osu-asdt/beavs-6/3dmodels/REL0014B.stp

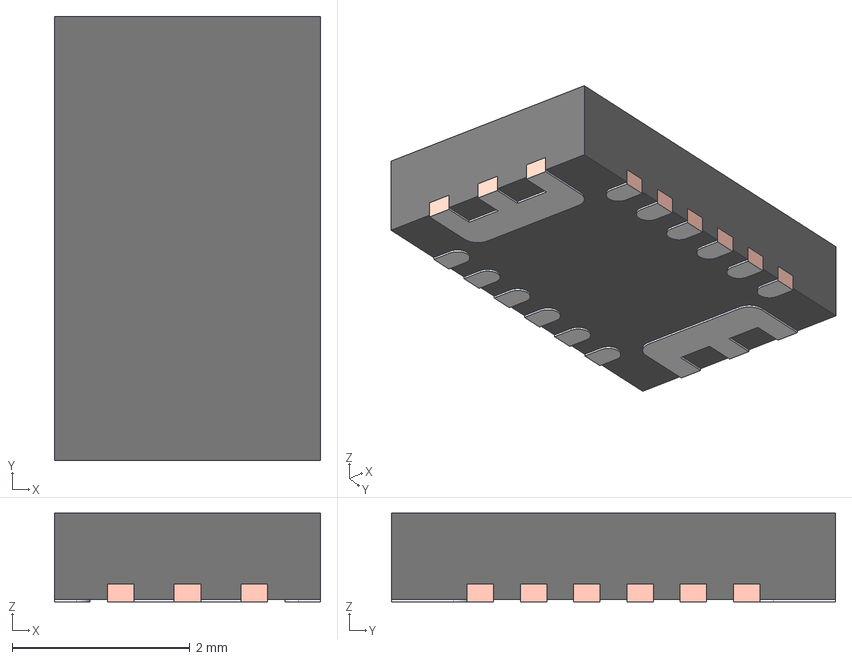
[picture p1: CAD file, 2025-11-22]
3dmodels/REL0014B.stp
3.00 x 5.00 x 1.00 mm
FRAME
PIN1_AREA
