osu-asdt/beavs-6/3dmodels/B3P-VH.STEP

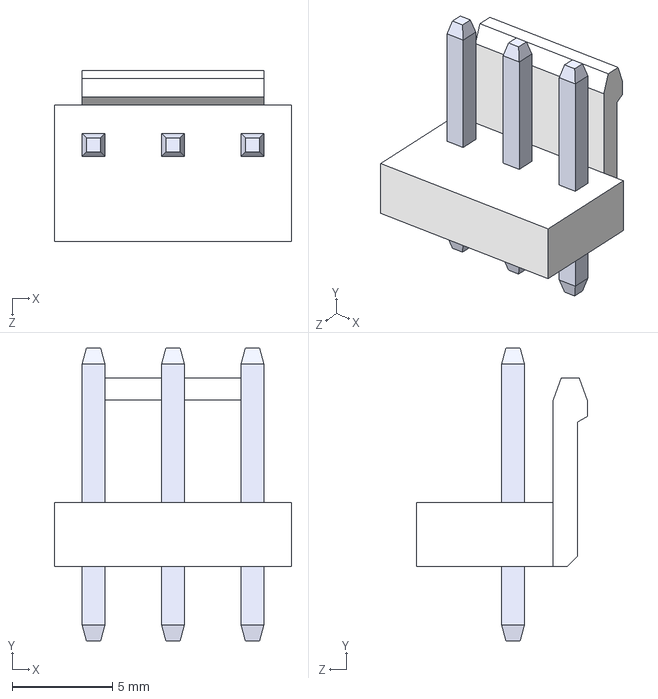
[picture p2: CAD file, 2025-11-22]
3dmodels/B3P-VH.STEP
11.8 x 14.6 x 8.50 mm
BxP-VH_3
pin x 3
