osu-asdt/beavs-6/beavs-sketch-0.kicad_pcb

## KiCad design beavs-sketch-0.kicad_pcb (2026-01-10)

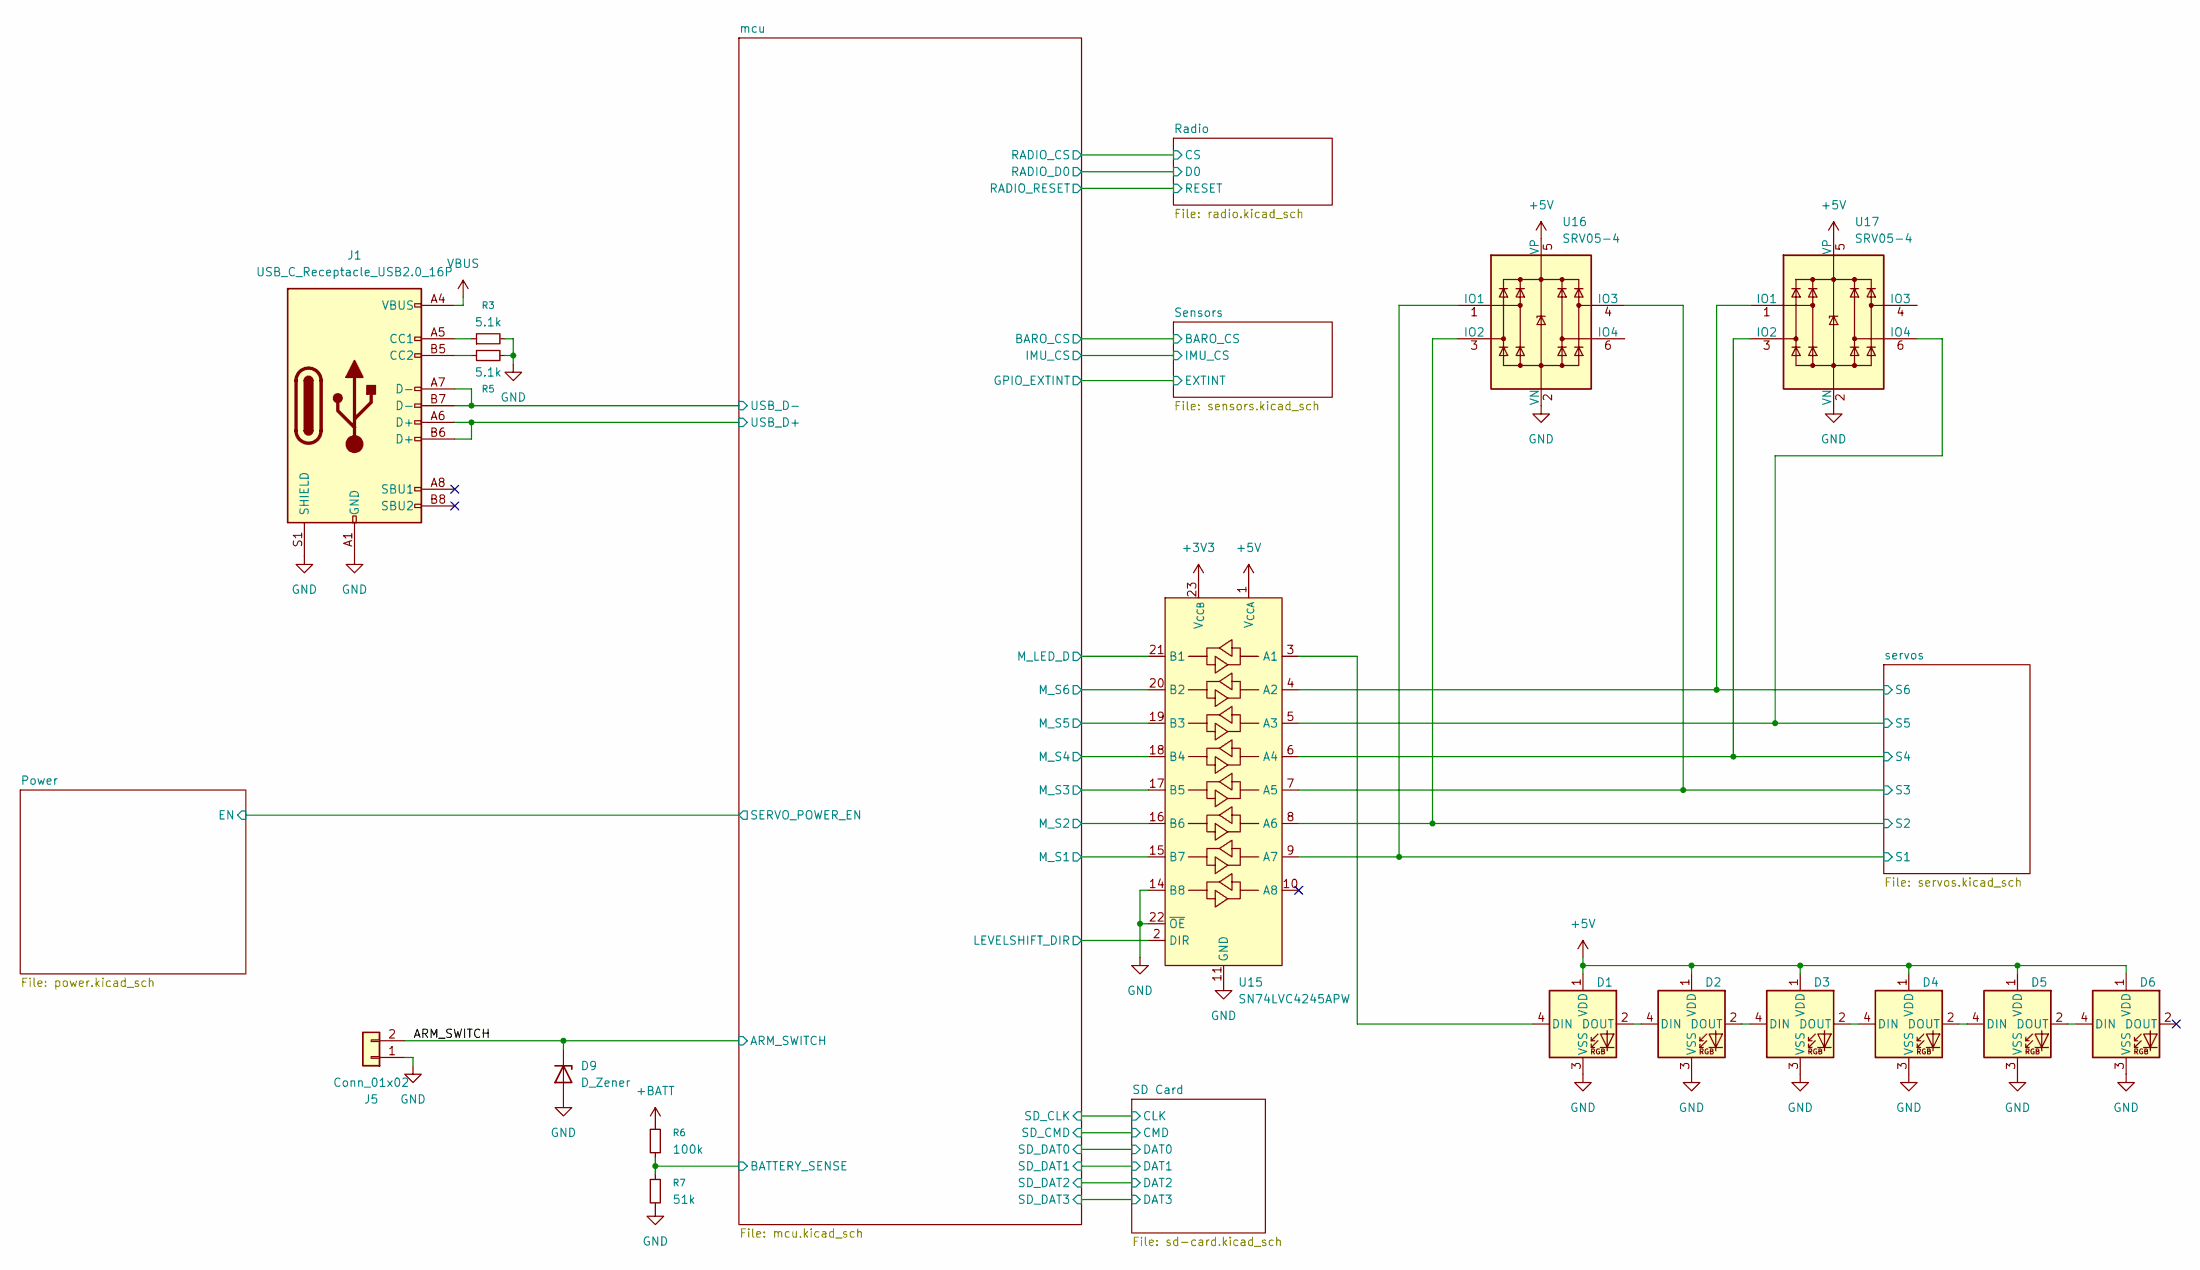
[picture p10: schematic beavs-sketch-0.kicad_sch]

Parts:
D1, D2, D3, D4, D5, D6: SK6812-EC20; LED_SK6812-EC20_PLCC4_2.0x2.0mm; LCSC C2909058
D9: D_Zener; D_SOD-323; LCSC C20615801
J1: USB_C_Receptacle_USB2.0_16P; USB_C_Receptacle_G-Switch_GT-USB-7010ASV; LCSC C2988369
J5: Conn_01x02; JST_PH_B2B-PH-K_1x02_P2.00mm_Vertical; digikey 455-1704-ND
R3, R5: 5.1k; R_0402_1005Metric; LCSC C25905
R6: 100k; R_0402_1005Metric; LCSC C25741
R7: 51k; R_0402_1005Metric; LCSC C25794
U15: SN74LVC4245APW; TSSOP-24_4.4x7.8mm_P0.65mm; LCSC C7859
U16, U17: SRV05-4; SOT-23-6; LCSC C7420376

Connections:
+3V3: U15.23 (V_{CCB}), U15.24 (V_{CCB}); also elsewhere on the board
+5V: D1.1 (VDD), D2.1 (VDD), D3.1 (VDD), D4.1 (VDD), D5.1 (VDD), D6.1 (VDD), U15.1 (V_{CCA}), U16.5 (VP), U17.5 (VP); also elsewhere on the board
+BATT: R6.1; also elsewhere on the board
/ARM_SWITCH: D9.1 (K), J5.2; also elsewhere on the board
/mcu/BATTERY_SENSE: R6.2, R7.1; also elsewhere on the board
/mcu/LEVELSHIFT_DIR: U15.2 (DIR); also elsewhere on the board
/mcu/M_LED_D: U15.21 (B1); also elsewhere on the board
/mcu/M_S1: U15.15 (B7); also elsewhere on the board
/mcu/M_S2: U15.16 (B6); also elsewhere on the board
/mcu/M_S3: U15.17 (B5); also elsewhere on the board
/mcu/M_S4: U15.18 (B4); also elsewhere on the board
/mcu/M_S5: U15.19 (B3); also elsewhere on the board
/mcu/M_S6: U15.20 (B2); also elsewhere on the board
/mcu/USB_D+: J1.A6 (D+), J1.B6 (D+); also elsewhere on the board
/mcu/USB_D-: J1.A7 (D-), J1.B7 (D-); also elsewhere on the board
/servos/S1: U15.9 (A7), U16.1 (IO1); also elsewhere on the board
/servos/S2: U15.8 (A6), U16.3 (IO2); also elsewhere on the board
/servos/S3: U15.7 (A5), U16.4 (IO3); also elsewhere on the board
/servos/S4: U15.6 (A4), U17.3 (IO2); also elsewhere on the board
/servos/S5: U15.5 (A3), U17.6 (IO4); also elsewhere on the board
/servos/S6: U15.4 (A2), U17.1 (IO1); also elsewhere on the board
GND: D1.3 (VSS), D2.3 (VSS), D3.3 (VSS), D4.3 (VSS), D5.3 (VSS), D6.3 (VSS), D9.2 (A), J1.A1 (GND), J1.A12 (GND), J1.B1 (GND), J1.B12 (GND), J1.S1 (SHIELD), J5.1, R3.2, R5.2, R7.2, U15.11 (GND), U15.12 (GND), U15.13 (GND), U15.14 (B8), U15.22 (~OE), U16.2 (VN), U17.2 (VN); also elsewhere on the board
unnamed: D1.4 (DIN), U15.3 (A1)
unnamed: D1.2 (DOUT), D2.4 (DIN)
unnamed: D2.2 (DOUT), D3.4 (DIN)
unnamed: D3.2 (DOUT), D4.4 (DIN)
unnamed: D4.2 (DOUT), D5.4 (DIN)
unnamed: D5.2 (DOUT), D6.4 (DIN)
unnamed: J1.A5 (CC1), R3.1
unnamed: J1.B5 (CC2), R5.1
VBUS: J1.A4 (VBUS), J1.A9 (VBUS), J1.B4 (VBUS), J1.B9 (VBUS); also elsewhere on the board

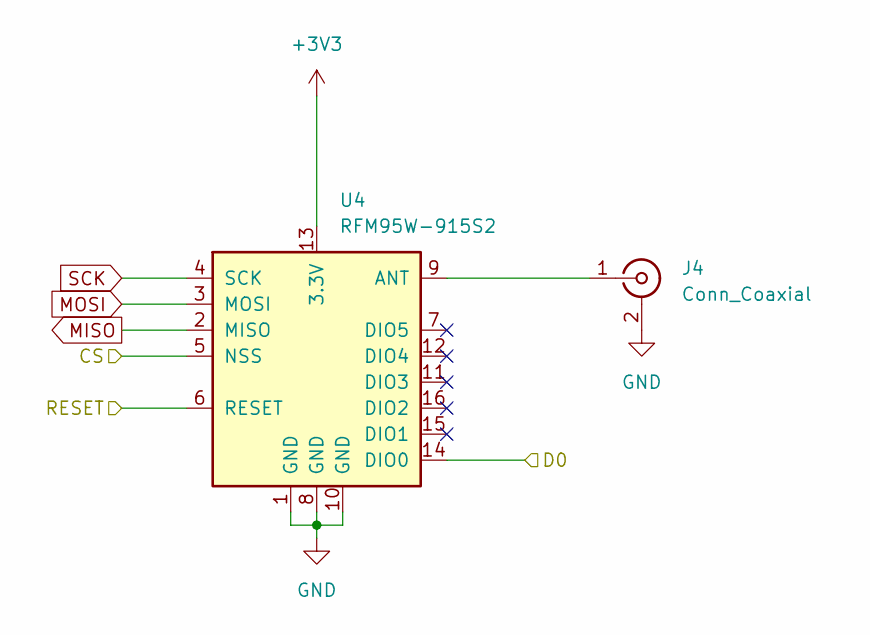
[picture p11: schematic radio.kicad_sch]

Parts:
J4: Conn_Coaxial; U.FL_Hirose_U.FL-R-SMT-1_Vertical; LCSC C88374
U4: RFM95W-915S2; HOPERF_RFM9XW_SMD

Connections:
+3V3: U4.13 (3.3V); also elsewhere on the board
/Radio/CS: U4.5 (NSS); also elsewhere on the board
/Radio/D0: U4.14 (DIO0); also elsewhere on the board
/Radio/RESET: U4.6 (RESET); also elsewhere on the board
GND: J4.2 (Ext), U4.1 (GND), U4.8 (GND), U4.10 (GND); also elsewhere on the board
MISO: U4.2 (MISO); also elsewhere on the board
MOSI: U4.3 (MOSI); also elsewhere on the board
unnamed: J4.1 (In), U4.9 (ANT)
SCK: U4.4 (SCK); also elsewhere on the board

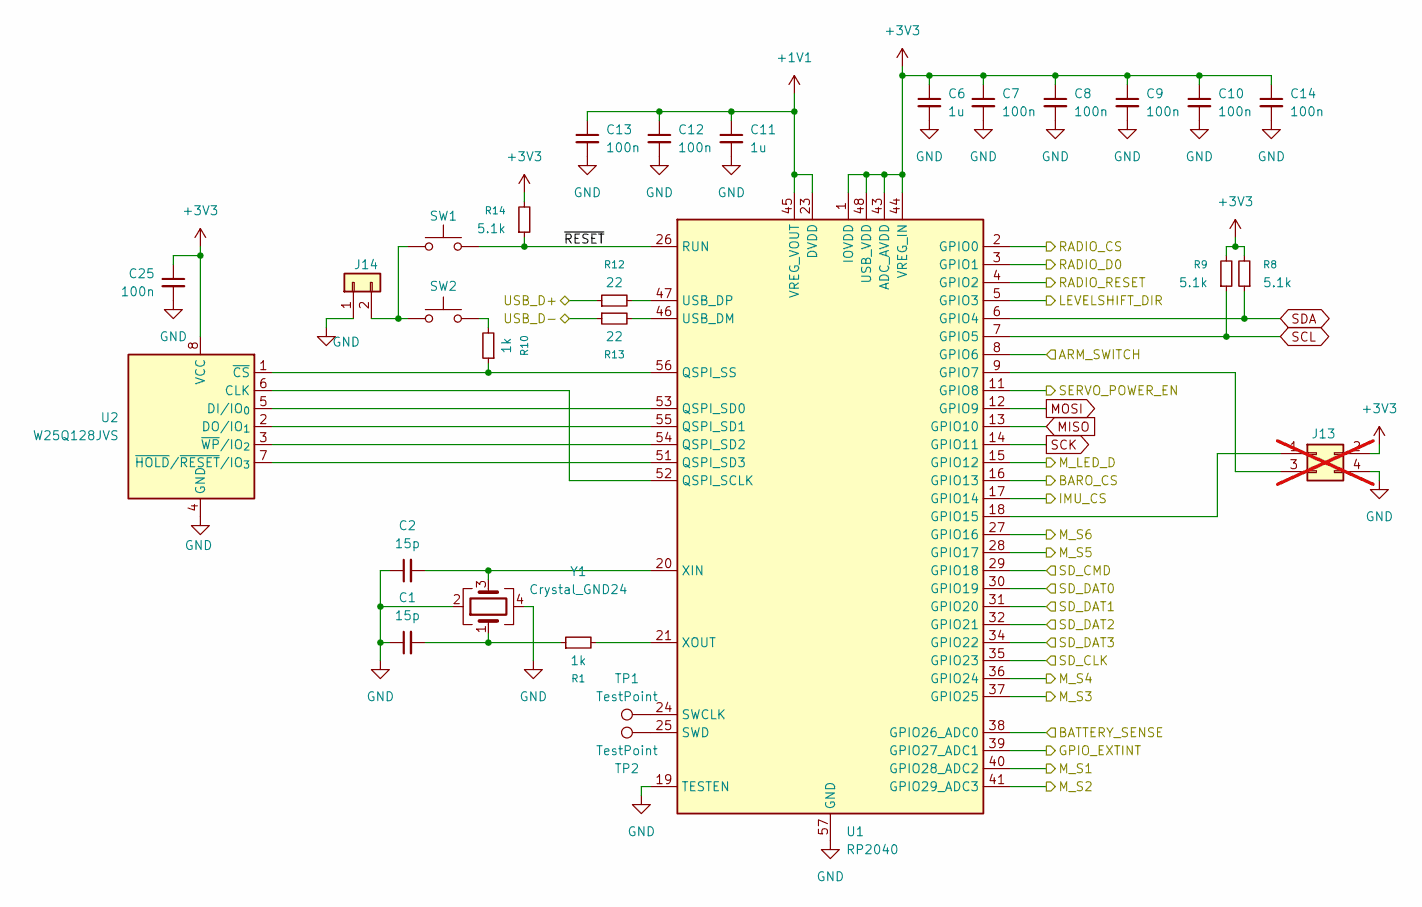
[picture p12: schematic mcu.kicad_sch]

Parts:
C1, C2: 15p; C_0402_1005Metric; LCSC C1548
C6, C11: 1u; C_0402_1005Metric; LCSC C52923
C7, C8, C9, C10, C12, C13, C14, C25: 100n; C_0402_1005Metric; LCSC C1525
J13: Conn_02x02_Odd_Even; PinHeader_2x02_P1.27mm_Vertical; not fitted
J14: Conn_01x02; PinHeader_1x02_P1.27mm_Vertical; digikey SAM1156-01-ND
R1, R10: 1k; R_0402_1005Metric; LCSC C11702
R8, R9, R14: 5.1k; R_0402_1005Metric; LCSC C25905
R12, R13: 22; R_0402_1005Metric; LCSC C25079
SW1, SW2: SW_Push; SW_SPST_TS-1088-AR02016; LCSC C720477
TP1, TP2: TestPoint; TestPoint_Pad_D1.0mm
U1: RP2040; QFN-56-1EP_7x7mm_P0.4mm_EP3.2x3.2mm; LCSC C2040
U2: W25Q128JVS; SOIC-8_5.3x5.3mm_P1.27mm; LCSC C97521
Y1: Crystal_GND24; Crystal_SMD_Abracon_ABM8AIG-4Pin_3.2x2.5mm; LCSC C20625731

Connections:
+1V1: C11.1, C12.1, C13.1, U1.23 (DVDD), U1.45 (VREG_VOUT), U1.50 (DVDD)
+3V3: C6.1, C7.1, C8.1, C9.1, C10.1, C14.1, C25.1, J13.2, R8.2, R9.2, R14.2, U1.1 (IOVDD), U1.10 (IOVDD), U1.22 (IOVDD), U1.33 (IOVDD), U1.42 (IOVDD), U1.43 (ADC_AVDD), U1.44 (VREG_IN), U1.48 (USB_VDD), U1.49 (IOVDD), U2.8 (VCC); also elsewhere on the board
/ARM_SWITCH: U1.8 (GPIO6); also elsewhere on the board
/Power/EN: U1.11 (GPIO8); also elsewhere on the board
/Radio/CS: U1.2 (GPIO0); also elsewhere on the board
/Radio/D0: U1.3 (GPIO1); also elsewhere on the board
/Radio/RESET: U1.4 (GPIO2); also elsewhere on the board
/SD Card/CLK: U1.35 (GPIO23); also elsewhere on the board
/SD Card/CMD: U1.29 (GPIO18); also elsewhere on the board
/SD Card/DAT0: U1.30 (GPIO19); also elsewhere on the board
/SD Card/DAT1: U1.31 (GPIO20); also elsewhere on the board
/SD Card/DAT2: U1.32 (GPIO21); also elsewhere on the board
/SD Card/DAT3: U1.34 (GPIO22); also elsewhere on the board
/Sensors/BARO_CS: U1.16 (GPIO13); also elsewhere on the board
/Sensors/EXTINT: U1.39 (GPIO27_ADC1); also elsewhere on the board
/Sensors/IMU_CS: U1.17 (GPIO14); also elsewhere on the board
/mcu/BATTERY_SENSE: U1.38 (GPIO26_ADC0); also elsewhere on the board
/mcu/LEVELSHIFT_DIR: U1.5 (GPIO3); also elsewhere on the board
/mcu/M_LED_D: U1.15 (GPIO12); also elsewhere on the board
/mcu/M_S1: U1.40 (GPIO28_ADC2); also elsewhere on the board
/mcu/M_S2: U1.41 (GPIO29_ADC3); also elsewhere on the board
/mcu/M_S3: U1.37 (GPIO25); also elsewhere on the board
/mcu/M_S4: U1.36 (GPIO24); also elsewhere on the board
/mcu/M_S5: U1.28 (GPIO17); also elsewhere on the board
/mcu/M_S6: U1.27 (GPIO16); also elsewhere on the board
/mcu/USB_D+: R12.1; also elsewhere on the board
/mcu/USB_D-: R13.1; also elsewhere on the board
/mcu/~RESET: R14.1, SW1.2, U1.26 (RUN)
GND: C1.1, C2.1, C6.2, C7.2, C8.2, C9.2, C10.2, C11.2, C12.2, C13.2, C14.2, C25.2, J13.4, J14.1, U1.19 (TESTEN), U1.57 (GND), U2.4 (GND), Y1.2, Y1.4; also elsewhere on the board
MISO: U1.13 (GPIO10); also elsewhere on the board
MOSI: U1.12 (GPIO9); also elsewhere on the board
unnamed: C1.2, R1.1, Y1.1
unnamed: J13.1, U1.18 (GPIO15)
unnamed: J13.3, U1.9 (GPIO7)
unnamed: J14.2, SW1.1, SW2.1
unnamed: R10.2, SW2.2
unnamed: U1.52 (QSPI_SCLK), U2.6 (CLK)
unnamed: U1.53 (QSPI_SD0), U2.5 (DI/IO_{0})
unnamed: U1.55 (QSPI_SD1), U2.2 (DO/IO_{1})
unnamed: U1.54 (QSPI_SD2), U2.3 (~WP/IO_{2})
unnamed: U1.51 (QSPI_SD3), U2.7 (~HOLD/~RESET/IO_{3})
unnamed: R10.1, U1.56 (QSPI_SS), U2.1 (~CS)
unnamed: TP1.1, U1.24 (SWCLK)
unnamed: TP2.1, U1.25 (SWD)
unnamed: R13.2, U1.46 (USB_DM)
unnamed: R12.2, U1.47 (USB_DP)
unnamed: C2.2, U1.20 (XIN), Y1.3
unnamed: R1.2, U1.21 (XOUT)
SCK: U1.14 (GPIO11); also elsewhere on the board
SCL: R9.1, U1.7 (GPIO5); also elsewhere on the board
SDA: R8.1, U1.6 (GPIO4); also elsewhere on the board

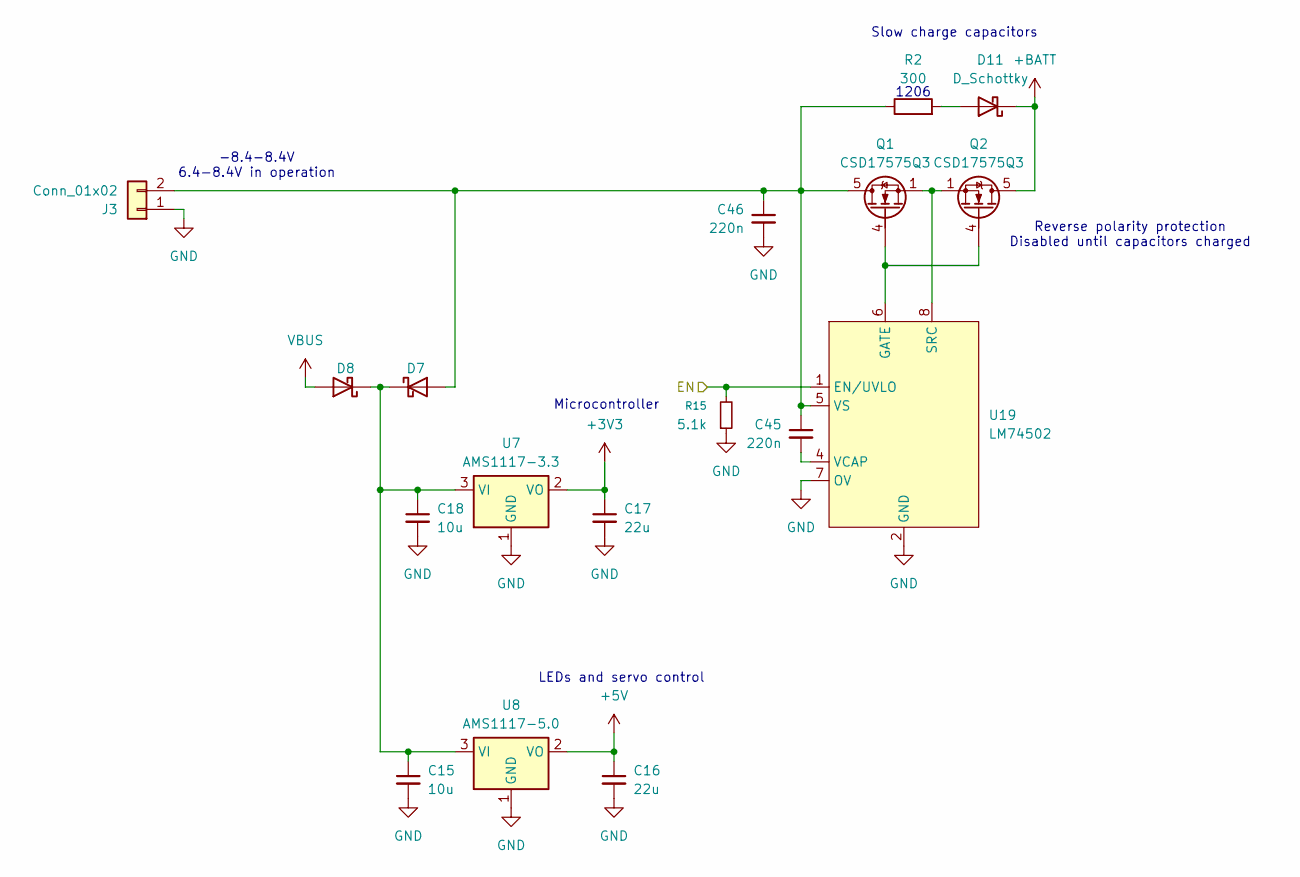
[picture p13: schematic power.kicad_sch]

Parts:
C15, C18: 10u; C_0603_1608Metric; LCSC C19702
C16, C17: 22u; C_0603_1608Metric; LCSC C59461
C45, C46: 220n; C_0402_1005Metric; LCSC C16772
D7, D8, D11: D_Schottky; D_SOD-123; LCSC C8598
J3: Conn_01x02; AMASS_XT30UPB-M_1x02_P5.0mm_Vertical
Q1, Q2: CSD17575Q3; SON-8-1EP-3.3x3.3mm-nexfet; LCSC C529277
R2: 300; R_1206_3216Metric; LCSC C17887
R15: 5.1k; R_0402_1005Metric; LCSC C25905
U7: AMS1117-3.3; SOT-223-3_TabPin2; LCSC C6186
U8: AMS1117-5.0; SOT-223-3_TabPin2; LCSC C6187
U19: LM74502; SOT-23-8-THIN; LCSC C5219203

Connections:
+3V3: C17.1, U7.2 (VO); also elsewhere on the board
+5V: C16.1, U8.2 (VO); also elsewhere on the board
+BATT: D11.1 (K), Q2.5 (D); also elsewhere on the board
/Power/EN: R15.2, U19.1 (EN/UVLO); also elsewhere on the board
GND: C15.2, C16.2, C17.2, C18.2, C46.2, J3.1, R15.1, U7.1 (GND), U8.1 (GND), U19.2 (GND), U19.7 (OV); also elsewhere on the board
unnamed: C45.1, C46.1, D7.2 (A), J3.2, Q1.5 (D), R2.1, U19.5 (VS)
unnamed: C15.1, C18.1, D7.1 (K), D8.1 (K), U7.3 (VI), U8.3 (VI)
unnamed: D11.2 (A), R2.2
unnamed: Q1.4 (G), Q2.4 (G), U19.6 (GATE)
unnamed: Q1.1 (S), Q1.2 (S), Q1.3 (S), Q2.1 (S), Q2.2 (S), Q2.3 (S), U19.8 (SRC)
unnamed: C45.2, U19.4 (VCAP)
VBUS: D8.2 (A); also elsewhere on the board

Notes on the sheet:
Slow charge capacitors
1206
Microcontroller
-8.4-8.4V 6.4-8.4V in operation
Reverse polarity protection Disabled until capacitors charged
LEDs and servo control

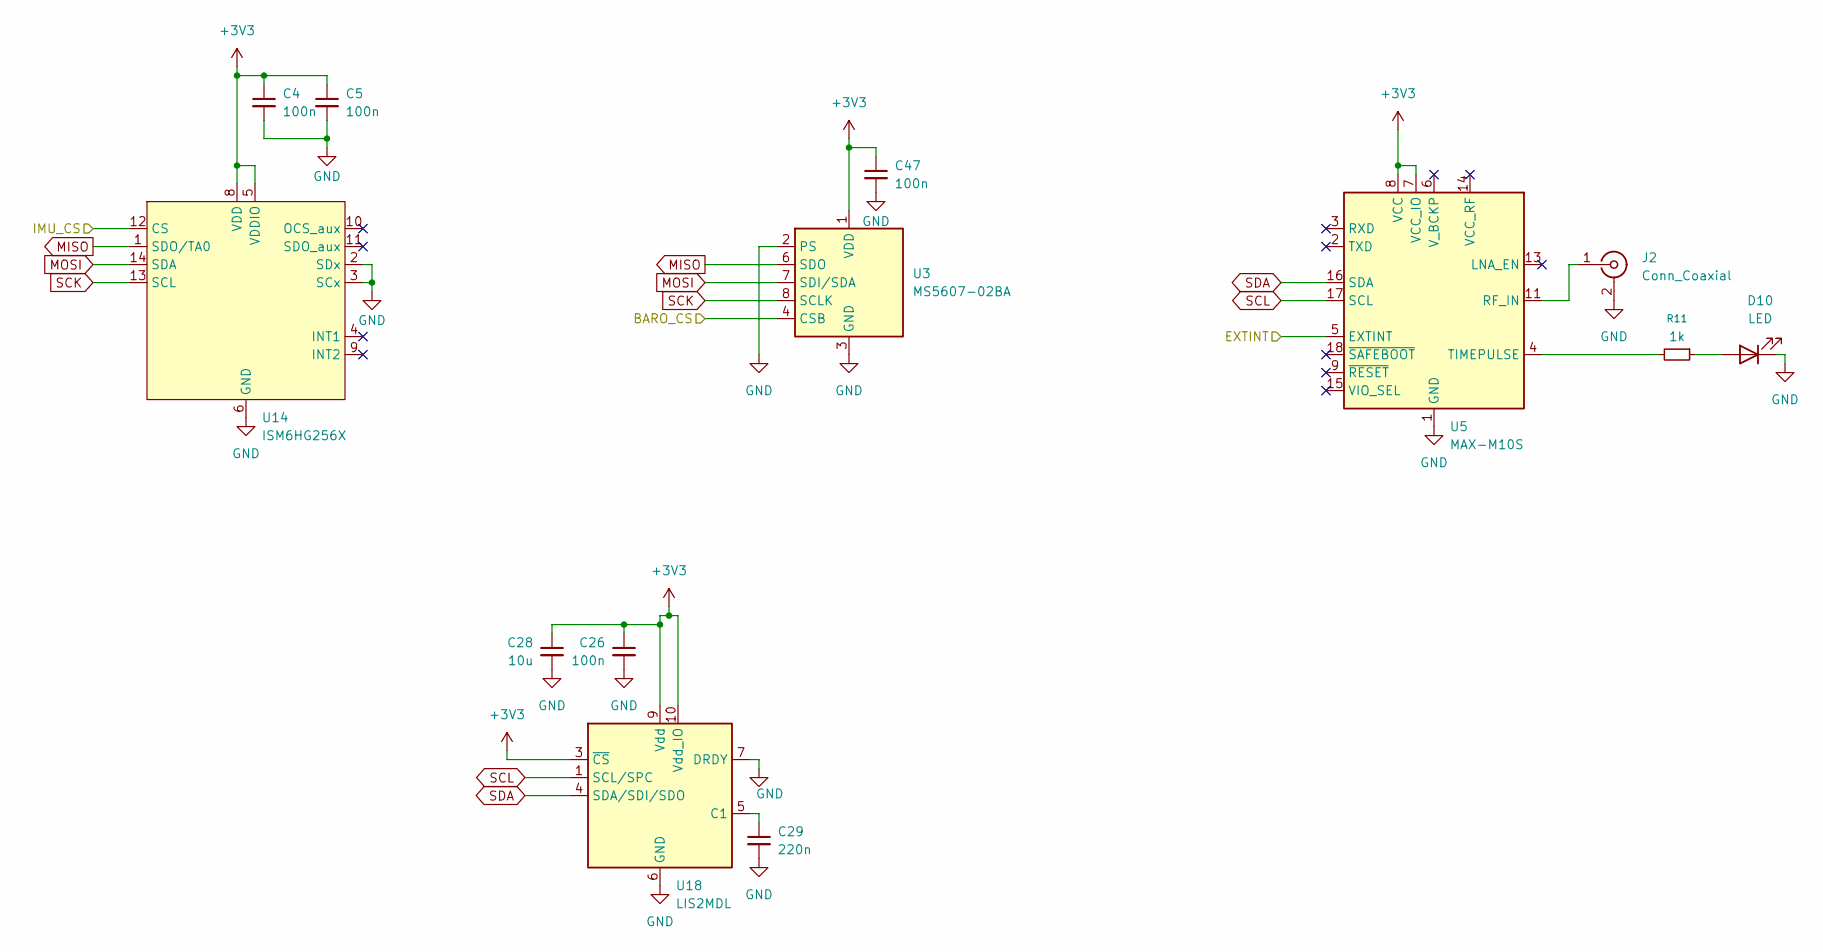
[picture p14: schematic sensors.kicad_sch]

Parts:
C4, C5, C26, C47: 100n; C_0402_1005Metric; LCSC C1525
C28: 10u; C_0402_1005Metric; LCSC C15525
C29: 220n; C_0402_1005Metric; LCSC C16772
D10: LED; LED_0805_2012Metric; LCSC C2297
J2: Conn_Coaxial; U.FL_Hirose_U.FL-R-SMT-1_Vertical; LCSC C88374
R11: 1k; R_0402_1005Metric; LCSC C11702
U3: MS5607-02BA; LGA-8_3x5mm_P1.25mm; LCSC C97627
U5: MAX-M10S; ublox_MAX; digikey 672-MAX-M10S-00BCT-ND
U14: ISM6HG256X; LGA-14_3x2.5mm_P0.5mm_LayoutBorder3x4y; digikey 497-ISM6HG256XTRCT-ND
U18: LIS2MDL; LGA-12_2x2mm_P0.5mm; digikey 497-17588-1-ND

Connections:
+3V3: C4.1, C5.1, C26.1, C28.1, C47.1, U3.1 (VDD), U5.7 (VCC_IO), U5.8 (VCC), U14.5 (VDDIO), U14.8 (VDD), U18.3 (~CS), U18.9 (Vdd), U18.10 (Vdd_IO); also elsewhere on the board
/Sensors/BARO_CS: U3.4 (CSB), U3.5 (CSB); also elsewhere on the board
/Sensors/EXTINT: U5.5 (EXTINT); also elsewhere on the board
/Sensors/IMU_CS: U14.12 (CS); also elsewhere on the board
GND: C4.2, C5.2, C26.2, C28.2, C29.2, C47.2, D10.1 (K), J2.2 (Ext), U3.2 (PS), U3.3 (GND), U5.1 (GND), U5.10 (GND), U5.12 (GND), U14.2 (SDx), U14.3 (SCx), U14.6 (GND), U14.7 (GND), U18.6 (GND), U18.7 (DRDY), U18.8 (GND); also elsewhere on the board
MISO: U3.6 (SDO), U14.1 (SDO/TA0); also elsewhere on the board
MOSI: U3.7 (SDI/SDA), U14.14 (SDA); also elsewhere on the board
unnamed: D10.2 (A), R11.1
unnamed: J2.1 (In), U5.11 (RF_IN)
unnamed: R11.2, U5.4 (TIMEPULSE)
unnamed: C29.1, U18.5 (C1)
SCK: U3.8 (SCLK), U14.13 (SCL); also elsewhere on the board
SCL: U5.17 (SCL), U18.1 (SCL/SPC); also elsewhere on the board
SDA: U5.16 (SDA), U18.4 (SDA/SDI/SDO); also elsewhere on the board

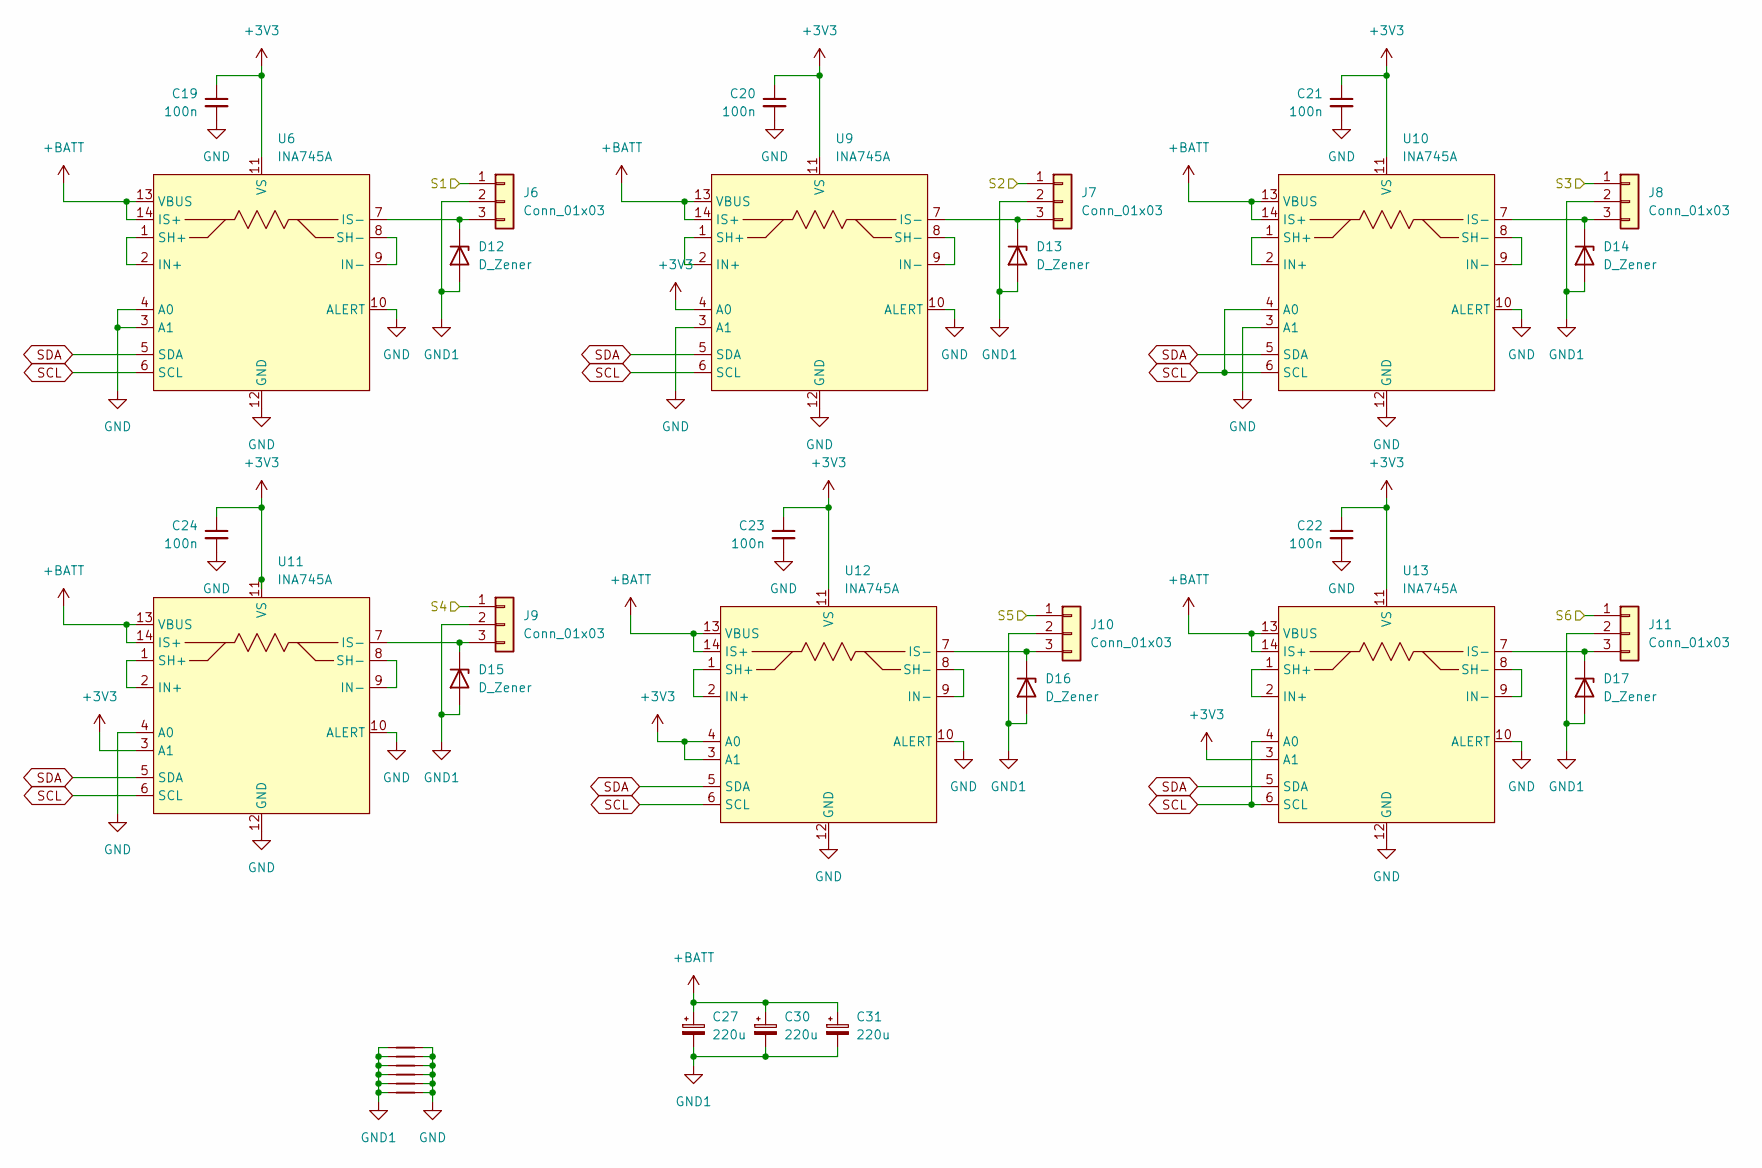
[picture p15: schematic servos.kicad_sch]

Parts:
C19, C20, C21, C22, C23, C24: 100n; C_0402_1005Metric; LCSC C1525
C27, C30, C31: 220u; CP_Radial_D5.0mm_P2.00mm; digikey 399-ESK227M010AC3AA-ND
D12, D13, D14, D15, D16, D17: D_Zener; Nexperia_CFP3_SOD-123W; digikey 1727-5361-1-ND
J6, J7, J8, J9, J10, J11: Conn_01x03; JST_VH_B3P-VH-B_1x03_P3.96mm_Vertical_model; digikey 455-B3P-VH-ND
NT1, NT2, NT3, NT4, NT5, NT6: NetTie_2; NetTie-2_SMD_Pad2.0mm
U6, U9, U10, U11, U12, U13: INA745A; QFN-14-REL_TI; LCSC C35213810

Connections:
+3V3: C19.1, C20.1, C21.1, C22.1, C23.1, C24.1, U6.11 (VS), U9.4 (A0), U9.11 (VS), U10.11 (VS), U11.3 (A1), U11.11 (VS), U12.3 (A1), U12.4 (A0), U12.11 (VS), U13.3 (A1), U13.11 (VS); also elsewhere on the board
+BATT: C27.1, C30.1, C31.1, U6.13 (VBUS), U6.14 (IS+), U9.13 (VBUS), U9.14 (IS+), U10.13 (VBUS), U10.14 (IS+), U11.13 (VBUS), U11.14 (IS+), U12.13 (VBUS), U12.14 (IS+), U13.13 (VBUS), U13.14 (IS+); also elsewhere on the board
/servos/S1: J6.1; also elsewhere on the board
/servos/S2: J7.1; also elsewhere on the board
/servos/S3: J8.1; also elsewhere on the board
/servos/S4: J9.1; also elsewhere on the board
/servos/S5: J10.1; also elsewhere on the board
/servos/S6: J11.1; also elsewhere on the board
GND: C19.2, C20.2, C21.2, C22.2, C23.2, C24.2, NT1.2, NT2.2, NT3.2, NT4.2, NT5.2, NT6.2, U6.3 (A1), U6.4 (A0), U6.10 (ALERT), U6.12 (GND), U9.3 (A1), U9.10 (ALERT), U9.12 (GND), U10.3 (A1), U10.10 (ALERT), U10.12 (GND), U11.4 (A0), U11.10 (ALERT), U11.12 (GND), U12.10 (ALERT), U12.12 (GND), U13.10 (ALERT), U13.12 (GND); also elsewhere on the board
GND1: C27.2, C30.2, C31.2, D12.2 (A), D13.2 (A), D14.2 (A), D15.2 (A), D16.2 (A), D17.2 (A), J6.2, J7.2, J8.2, J9.2, J10.2, J11.2, NT1.1, NT2.1, NT3.1, NT4.1, NT5.1, NT6.1
unnamed: D12.1 (K), J6.3, U6.7 (IS-)
unnamed: D13.1 (K), J7.3, U9.7 (IS-)
unnamed: D14.1 (K), J8.3, U10.7 (IS-)
unnamed: D15.1 (K), J9.3, U11.7 (IS-)
unnamed: D16.1 (K), J10.3, U12.7 (IS-)
unnamed: D17.1 (K), J11.3, U13.7 (IS-)
unnamed: U6.1 (SH+), U6.2 (IN+)
unnamed: U6.8 (SH-), U6.9 (IN-)
unnamed: U9.1 (SH+), U9.2 (IN+)
unnamed: U9.8 (SH-), U9.9 (IN-)
unnamed: U10.1 (SH+), U10.2 (IN+)
unnamed: U10.8 (SH-), U10.9 (IN-)
unnamed: U11.1 (SH+), U11.2 (IN+)
unnamed: U11.8 (SH-), U11.9 (IN-)
unnamed: U12.1 (SH+), U12.2 (IN+)
unnamed: U12.8 (SH-), U12.9 (IN-)
unnamed: U13.1 (SH+), U13.2 (IN+)
unnamed: U13.8 (SH-), U13.9 (IN-)
SCL: U6.6 (SCL), U9.6 (SCL), U10.4 (A0), U10.6 (SCL), U11.6 (SCL), U12.6 (SCL), U13.4 (A0), U13.6 (SCL); also elsewhere on the board
SDA: U6.5 (SDA), U9.5 (SDA), U10.5 (SDA), U11.5 (SDA), U12.5 (SDA), U13.5 (SDA); also elsewhere on the board

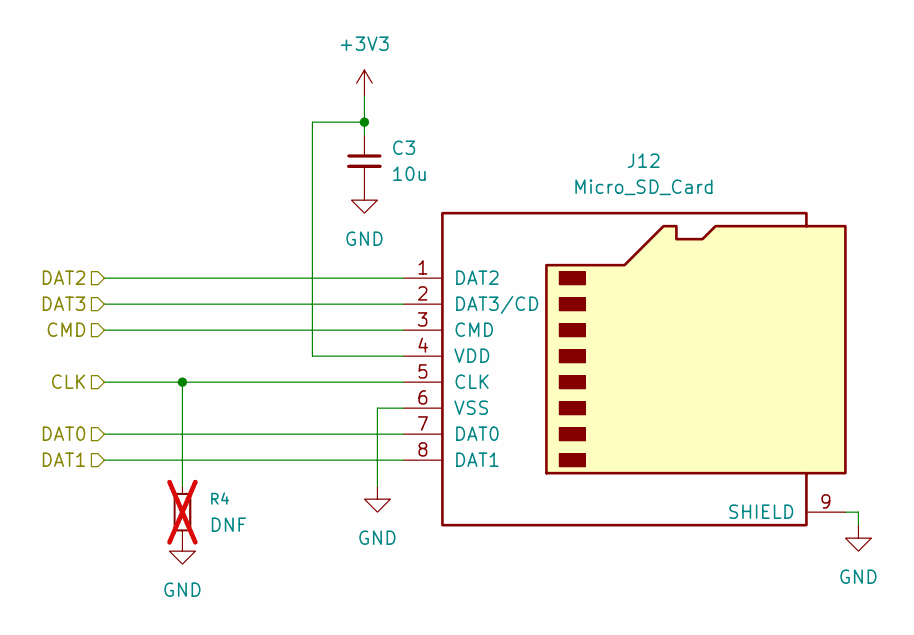
[picture p16: schematic sd-card.kicad_sch]

Parts:
C3: 10u; C_0402_1005Metric; LCSC C15525
J12: Micro_SD_Card; microSD_HC_Molex_47219-2001; LCSC C164170
R4: DNF; R_0402_1005Metric; not fitted

Connections:
+3V3: C3.1, J12.4 (VDD); also elsewhere on the board
/SD Card/CLK: J12.5 (CLK), R4.1; also elsewhere on the board
/SD Card/CMD: J12.3 (CMD); also elsewhere on the board
/SD Card/DAT0: J12.7 (DAT0); also elsewhere on the board
/SD Card/DAT1: J12.8 (DAT1); also elsewhere on the board
/SD Card/DAT2: J12.1 (DAT2); also elsewhere on the board
/SD Card/DAT3: J12.2 (DAT3/CD); also elsewhere on the board
GND: C3.2, J12.6 (VSS), J12.9 (SHIELD), R4.2; also elsewhere on the board

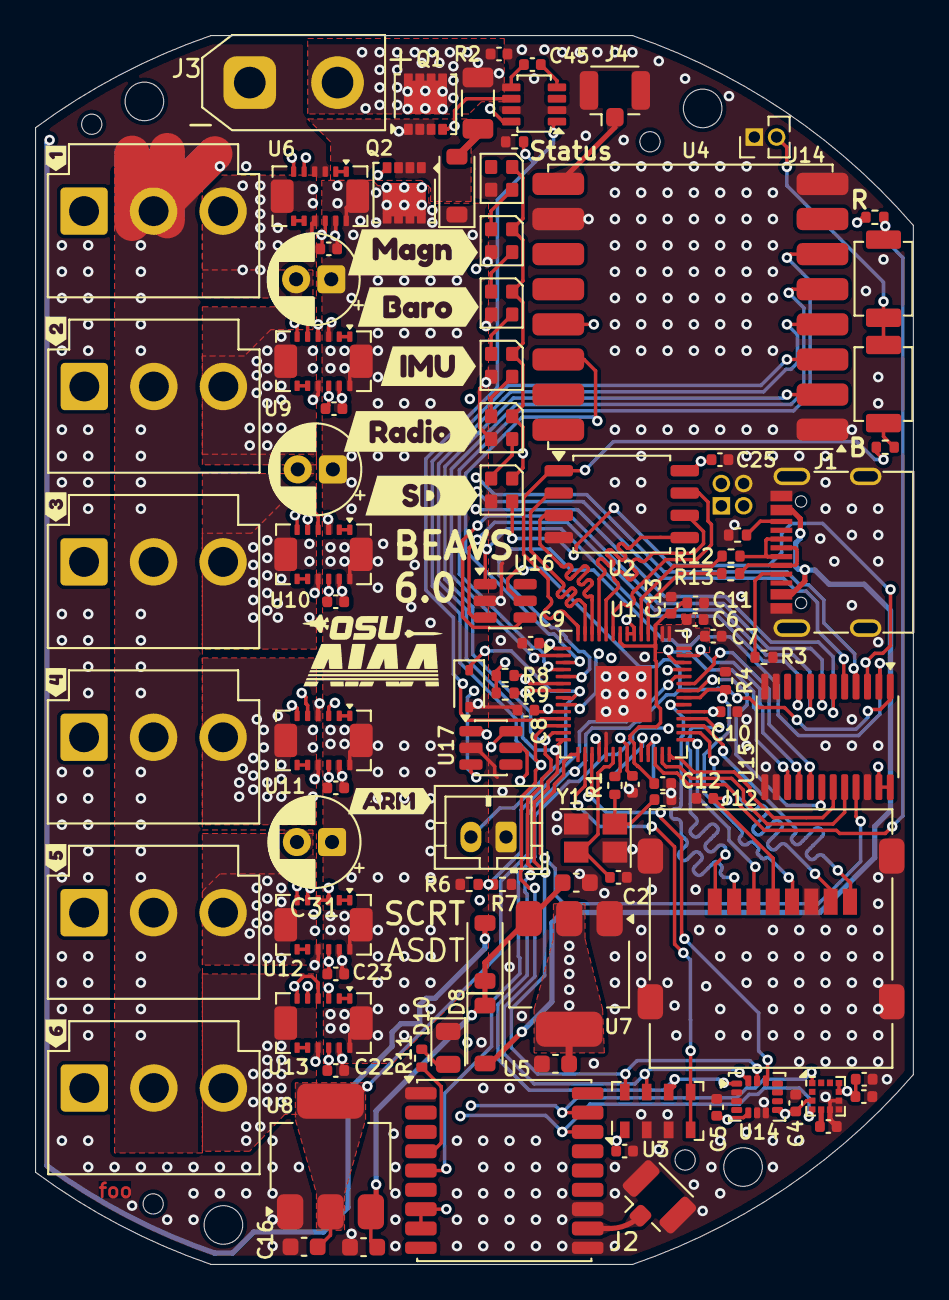
[picture p17: board beavs-sketch-0.kicad_pcb from above]

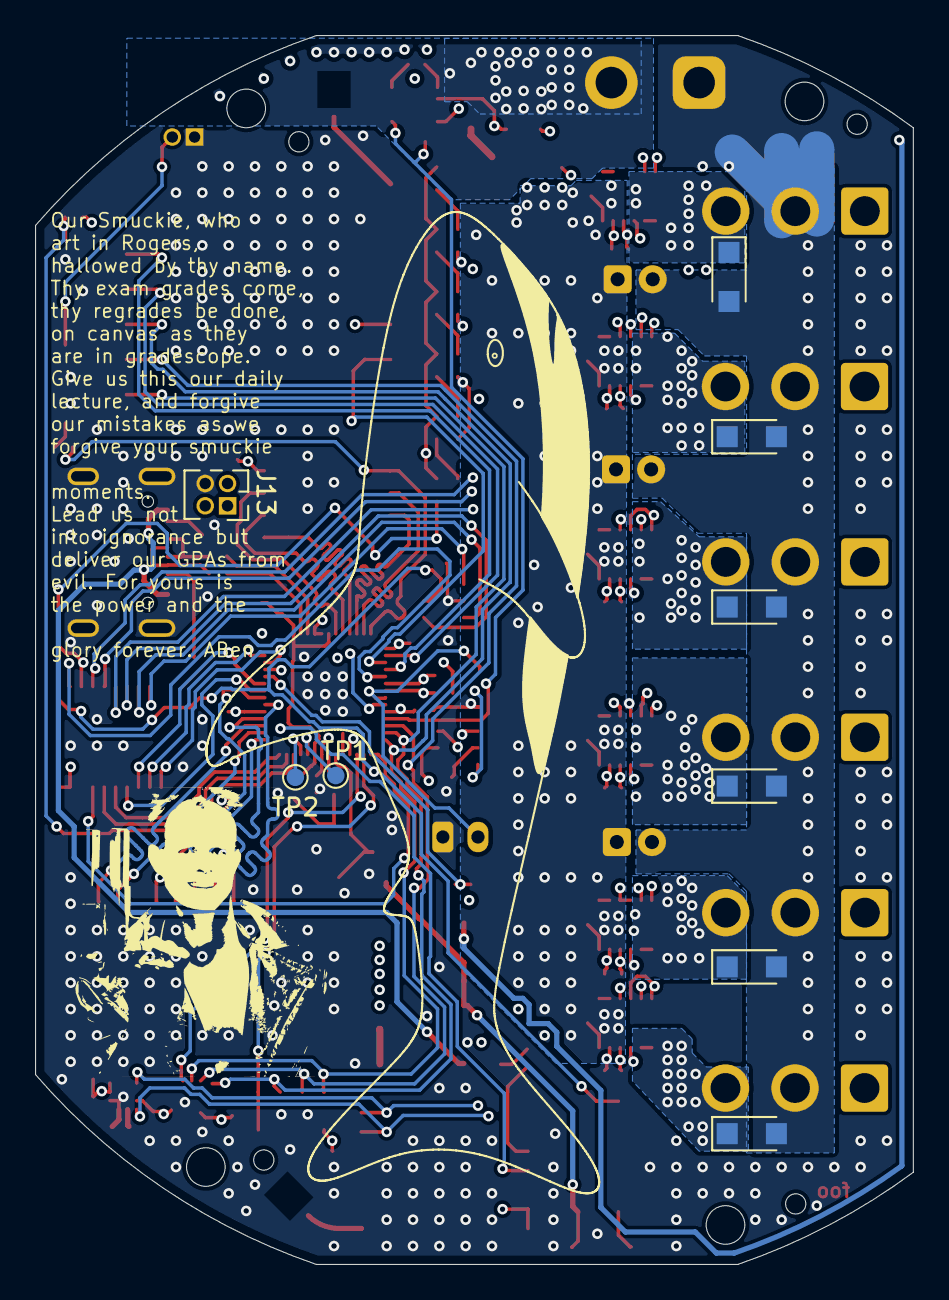
[picture p18: board beavs-sketch-0.kicad_pcb from below]

Board: 4 copper layers, 50.0 x 70.0 mm, 124 parts (12 on the bottom side), 98 nets.

Other parts of the board:
kibuzzard-6930C9BE: G***; kibuzzard-6930C9BE
kibuzzard-6930C9FF: G***; kibuzzard-6930C9FF
kibuzzard-6945FAFA: G***; kibuzzard-6945FAFA
kibuzzard-6945FB0B: G***; kibuzzard-6945FB0B
kibuzzard-6945FB1F: G***; kibuzzard-6945FB1F
kibuzzard-6945FB15: G***; kibuzzard-6945FB15
kibuzzard-6945FB28: G***; kibuzzard-6945FB28
kibuzzard-6945FB30: G***; kibuzzard-6945FB30
kibuzzard-6945FC37: G***; kibuzzard-6945FC37
kibuzzard-693096D7: G***; kibuzzard-693096D7
kibuzzard-69309731: G***; kibuzzard-69309731
kibuzzard-69309760: G***; kibuzzard-69309760
