osu-asdt/beavs-6/(commit log)

2025-11-21 do some schematic work
2025-11-21 importing CAD edge cuts
2025-11-23 add some TVS diodes
2025-11-25 update schematics and add 3d models
2025-12-03 change out LEDs, add silk, start getting ready for fab
2025-12-04 stapling vias, silk, minor schematic tweaks
2025-12-04 capacitor spam, needs current limiting
2025-12-04 moved to ideal diode + back to back FETs
2025-12-06 finished power, checked most sensor schematics
2025-12-07 bigger pours for FETs, various cleanup, switching to different level shifter
2025-12-09 switched around some footprints, added expansion header
2025-12-20 switched to global labels for SPI and I2C, added labels for servos
2026-01-09 fix pin order on FETs, cleanup
2026-01-09 switching to electrolytic caps
2026-01-15 add schematic PDF, improve schematic readability
